thankthemaker/rESCue/docs/images/adafruit_products_Adafruit_ESP32_Huzzah_Breakout_Pinout.png

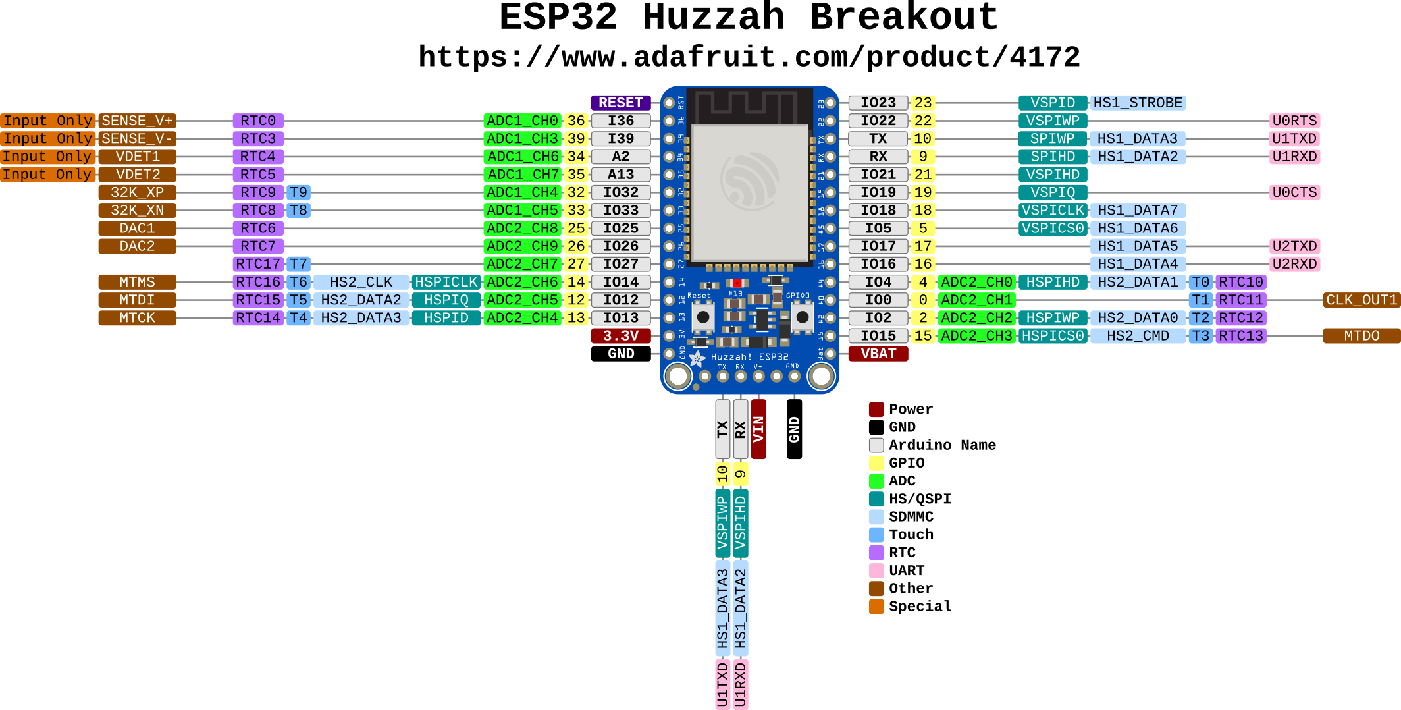
docs/images/adafruit_products_Adafruit_ESP32_Huzzah_Breakout_Pinout.png
