thankthemaker/rESCue/docs/images/rESCue-Blynk-QR.jpeg

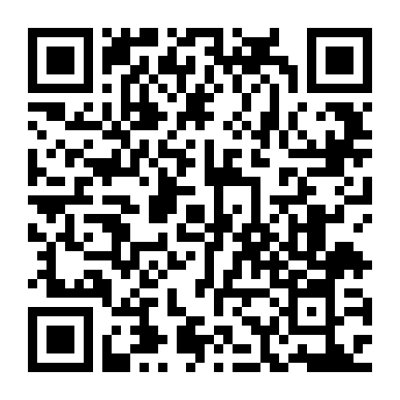
docs/images/rESCue-Blynk-QR.jpeg
