thankthemaker/rESCue/docs/images/rESCue-Blynk.png

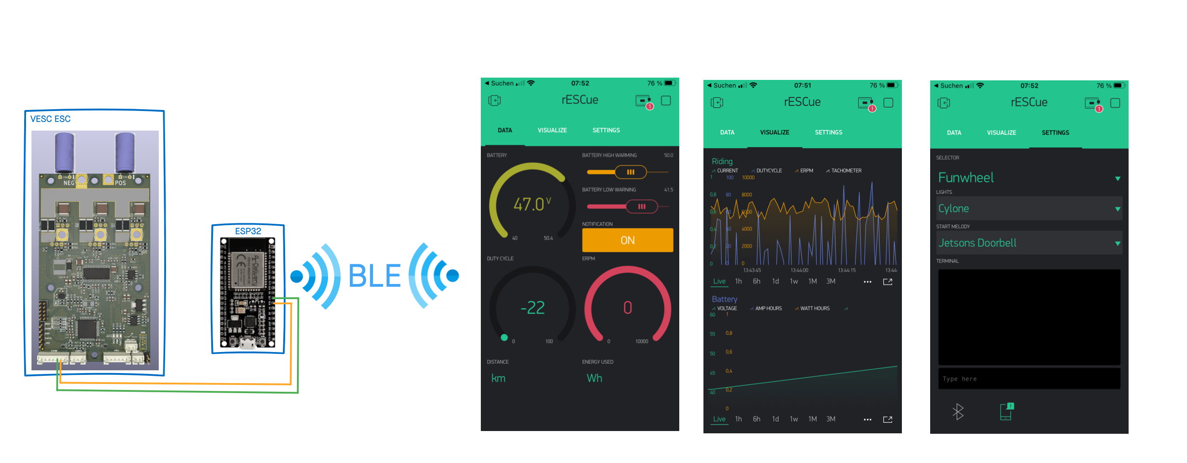
docs/images/rESCue-Blynk.png
