thankthemaker/rESCue/docs/images/wheelbarrow-rev3.png

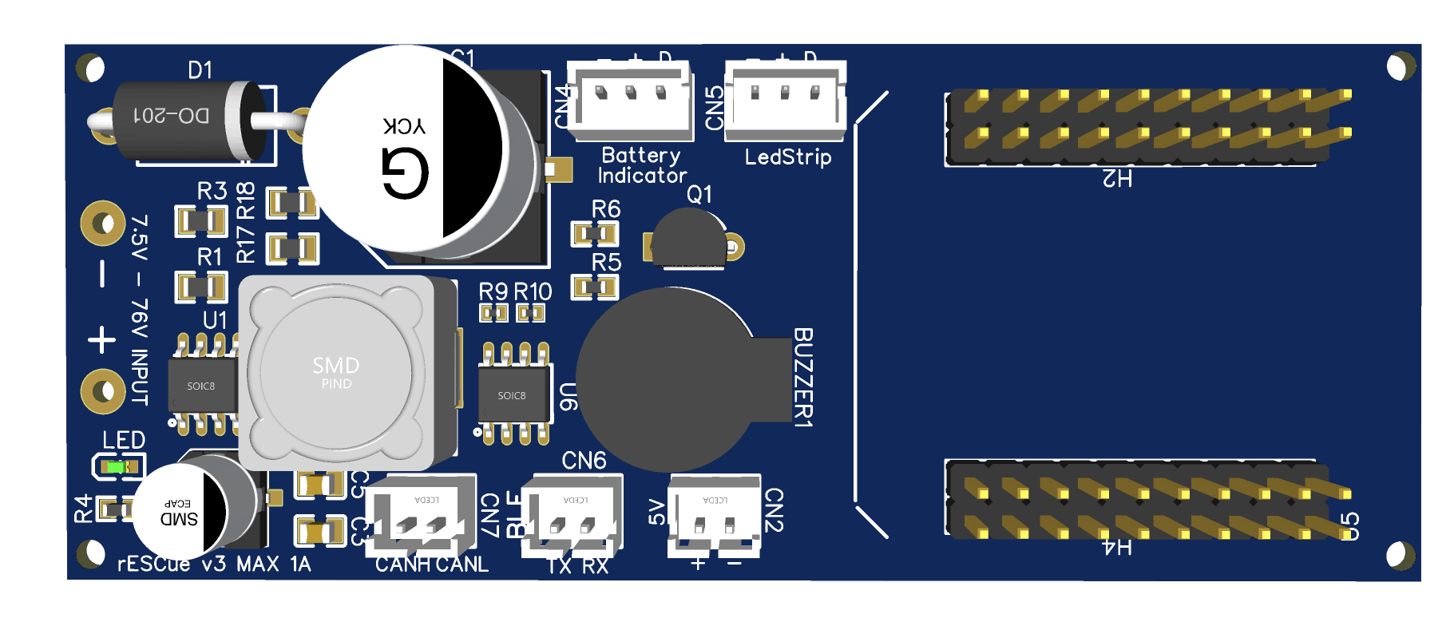
docs/images/wheelbarrow-rev3.png
