thankthemaker/rESCue/CHANGELOG.md

# Changelog for rESCue firmware
rESCue now uses Github releases, so you can see the changes in Github : https://github.com/thankthemaker/rESCue/releases

## Release 1.3.8 (not yet released)

## 12.09.2021

- switch to another CANBUS lib

## Release 1.3.7

## 12.09.2021

- Fixed some small issues in canbus
- switched back to stock version of the CANBUS lib  
- released v1.3.6

## Release 1.3.6

### 20.08.2021

- Fixed some issues when COB is used
- updated Readme, added MOSFET-Switch
- released v1.3.6

### 19.08.2021

- Fixed an issue in the CANBUS-lib. Sending messages without a working CANBUS makes ESP freeze

### 18.08.2021

- implemented changing LogLevel via Blynk-App

## Release 1.3.5

### 16.08.2021

- eliminated hard coded VESC-ID

## Release 1.3.4

### 16.08.2021

- fixed CAN-issue with VESC version 5.3
- prepared release 1.3.4

### 20.07.2021

- fixed WiFi OTA update by changing partition schema to default
- fixed "Guru Meditation Error: Core 1 panic'ed (Cache disabled but cached memory region accessed)" while OTA
- fixed app crash when App-Configuration is written and not dividable by 6 byte

## Release 1.3.3

### 19.07.2021

- improved CANBUS communication
- Fixed bug that CANBUS freezes when sending multiple frames at the same time

## Release 1.3.1

- bugfix lights, erpm was read wrong sometimes

## Release 1.3.0

### 27.06.2021

- prepared release 1.3.0

### 25.06.2021

- added Footpad sensor state to lightbar
- some small fixes

### 24.06.2021

- New light pattern pulse
- small bugfix, pattern change when start-sequence finished
- small bugfix, brightness ignored in start sequence

### 22.06.2021

- Updated Readme (CANBUS only)

## Release 1.2.0

### 15.06.2021

- implemented CANBUS-only read and write mode
- prepared release 1.2.0

### 08.06.2021

 - Working WiFI OTA

## Release 1.1.1

### 24.05.2021

- **Release 1.1.1**
- prepared release 1.1.1

### 24.05.2021

- prepared release 1.1.1
- improved OTA update, package resend and delay to give BLE stack time
- LightBar fixed
- bugfixing idle light

## Release 1.1.0

### 20.05.2021

- **Release 1.1.0**
- improved OTA and enrollment
- initial Lightbar
- startsound for OTA
- prepared release 1.1.0

### 15.05.2021

- updated README
- fixed wron macro definition

### 03.05.2021

- added OTA documentation

### 01.05.2021

- more configuration options

### 30.04.2021

- Updated Blynk App to v1.1
- Updated QR code

### 29.04.2021

- updated PIN configuration according to rev3 of the rESCue PCB
- updated documentation
- some more light magic

### 28.04.2021

- sound can be turned off
- added more sounds
- sound "preview" when selected
- Blynk app reads settings on connect
- fixed the fading bugs and made it smoother

### 27.04.2021

- fixed some bugs in fading lights
- smoother fading

### 20.04.2021

- updated doc, PCB image and sizing

## Release 1.0.0

### 19.04.2021

- **Release 1.0.0**
- added Over The Air (OTA) update
- changed partition layout (min-spiff)
- fixed blynk mapping

### 15.04.2021

- Fixed "braking lights"

### 14.04.2021

- updated outdated Adafruit Neopixel lib to 1.7.0

### 12.04.2021

- added syncPreferences to BleServer to sync saved preferences with Blynk onConnect
- added "brake light" detection when current <-4.0A (regen)
- read some more props from VESC ("totalCurrentIn" and "pidPosition")

- updated Blynk QR-Code
