thankthemaker/rESCue/(threads)

Thread 4 (2021-05-25):

piezo buzzer

Koxx3, 2021-05-25:
Hello,
very nice project !
I am curious about the piezo buzzer.
it works with an audible noise even in the enclosure with 3.3V ?
did you measure the current ? not drawing to much current from ESP pin ?
Regards,
F.

thankthemaker, 2021-05-25:
Hi,
to get a really loud sound, you'll need to add a simple transistor, e.g. a BC547.
If a buzzer does any harm to your ESP depends on the type. Piezo buzzer normally don't drain more than 20mA which is ok for the ESP32. Magnetic buzzer may drain much more and could damage the MCU.
Here is a good description:
https://diyi0t.com/active-passive-buzzer-arduino-esp8266-esp32/

I'd always recommend to use a transistor.

Koxx3, 2021-05-25:
thanks for the answer ;)
20 mA is already a lot for the ESP32 (12mA recommended if I have good memory)  ;)
I also think transistor is a good idea :D

thankthemaker, 2021-05-25:
According to the table on the page I posted, 12mA is for ESP8266.
The ESP32 can handle 20mA.
At least I never damaged an ESP32 by connecting a piezo buzzer.

Closed 2021-05-25.

Thread 5 (2021-05-25):

schematics for PCB

Koxx3, 2021-05-25:
hello,
could you publish the PCB schematics on the github ?
Regards,
F.

thankthemaker, 2021-05-25:
I'm not the creator of the PCB, so I can't publish the schematics.
Jonas is the guy who did a amazing job and he also told me he'll publish the complete project as open hardware once it is finished.

Koxx3, 2021-05-25:
awesome ;)
thanks for the feedback.
I am creating something a bit similar for escooters (with multiple controllers capability) ;)
https://github.com/Koxx3/SmartController_SmartDisplay_ESP32

If you have Telegram, we can talk (https://t.me/koxx3) 👍

thankthemaker, 2021-05-25:
Sounds great. Have to read it.

thankthemaker, 2021-06-05:
This repository contains only the firmware.
The hardware, once released as open hardware, will be placed in a new repository.

Closed 2021-06-05.

Thread 8 (2021-06-05):

Support for active piezo buzzer

thankthemaker, 2021-06-05:
The current firmware does only support passive piezo buzzer. Add support for active buzzers also.

Thread 15 (2021-09-07):

Feature request: turn off lights while charging

thankthemaker, 2021-09-07:
Floatwheel / Balance Pro turns on while charging, so it makes sense to turn off the lights when in idle state for longer than xx seconds.

thankthemaker, 2021-12-03:
Implemented an idle-light timeout. Its default value is 60 seconds but can be changed via app. When the timeout is reached while the wheel is still idle, the lights will completely turn off.

thankthemaker, 2021-12-03:
Available from version 2.0.0

Closed 2021-12-03.

Thread 16 (2021-11-12):

CAN bus / BLE gateway

Koxx3, 2021-11-12:
Hello,
do you think it would be possible to make a CAN <> BLE gateway ?

thankthemaker, 2021-11-13:
Hi, that's exactly what rESCue already does, at least if you're talking of the VESC protocol.
If you're talking about a generic solution, sure, this will also be possible but isn't part of rESCue already.

Could you please tell me a bit more, what exactly your intention is all about?

Koxx3, 2021-11-13:
I'd like to use it as a simple gateway for either BLE <> UART or BLE <> CAN.

BLE <> UART works fine. Now, I try the CAN version.

VESC configuration is in CAN_STATUS_1_2_3_4_5 enabled at 50Hz and 500KBps.
I currently have a single VESC (but I want it to work on dual CAN VESC).

I understood the proxyIn/proxyOut and got some results.
First, I had to reduce Logger traces. Verbose seems to give some issues (certainly slowing down the CAN frame processing).

But once connected in BLE, I can read real time datas, read MC/APP conf, but I can't write APP conf. Any idea why ? It's a long packet (but like MC conf), but I don't understand why this one is not working.

My test fork is here (I change the pinout for UART & CAN) :
https://github.com/Koxx3/rESCue

Koxx3, 2021-11-13:
I've just push the commit in the fork ;)

thankthemaker, 2021-11-13:
OK, so we're talking of the VESC protocol.
 I'll have to have a look at it. It might be a problem with the length of the config. Normally all data is passed to the CAN bus as is and vice versa, but due to different framing (package sizes) it has to be repacked. The VESC protocol distinguishes between different package sizes and I guess it could be a problem if e.g. the last CAN package isn't a complete package.

Koxx3, 2021-11-13:
even for MC conf writing, it doesn't work all the time

Koxx3, 2021-11-13:
working sequence :

`
FWC: [NOTICE] : BleServer BLE to VESC : len = 20
FWC: [NOTICE] : CanBus Proxy in  : STREAM => CAN, command 13, length 458, longPacket 1
FWC: [NOTICE] : BleServer BLE to VESC : len = 20
FWC: [NOTICE] : BleServer BLE to VESC : len = 20
FWC: [NOTICE] : BleServer BLE to VESC : len = 20
FWC: [NOTICE] : BleServer BLE to VESC : len = 20
FWC: [NOTICE] : BleServer BLE to VESC : len = 20
FWC: [NOTICE] : BleServer BLE to VESC : len = 20
FWC: [NOTICE] : BleServer BLE to VESC : len = 20
FWC: [NOTICE] : BleServer BLE to VESC : len = 20
FWC: [NOTICE] : BleServer BLE to VESC : len = 20
FWC: [NOTICE] : BleServer BLE to VESC : len = 20
FWC: [NOTICE] : BleServer BLE to VESC : len = 20
FWC: [NOTICE] : BleServer BLE to VESC : len = 20
FWC: [NOTICE] : BleServer BLE to VESC : len = 20
FWC: [NOTICE] : BleServer BLE to VESC : len = 20
FWC: [NOTICE] : BleServer BLE to VESC : len = 20
FWC: [NOTICE] : BleServer BLE to VESC : len = 20
FWC: [NOTICE] : BleServer BLE to VESC : len = 20
FWC: [NOTICE] : BleServer BLE to VESC : len = 20
FWC: [NOTICE] : BleServer BLE to VESC : len = 20
FWC: [NOTICE] : BleServer BLE to VESC : len = 20
FWC: [NOTICE] : BleServer BLE to VESC : len = 20
FWC: [NOTICE] : BleServer BLE to VESC : len = 20
FWC: [NOTICE] : BleServer BLE to VESC : len = 4
FWC: [NOTICE] : BleServer BLE to VESC : len = 6
FWC: [NOTICE] : CanBus Proxy in  : STREAM => CAN, command 14, length 1, longPacket 0
FWC: [NOTICE] : CanBus Proxy out : CAN => STREAM, sending 2 bytes
FWC: [NOTICE] : CanBus Proxy out : CAN => STREAM, sending 458 bytes
FWC: [NOTICE] : BleServer VESC to BLE : len = 471`

thankthemaker, 2021-11-13:
Are you using the VESC tool app for testing?

Koxx3, 2021-11-13:
yes, android vesctool with samsung Galaxy S10E.

Koxx3, 2021-11-13:
failing writing APP conf :

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

thankthemaker, 2021-11-13:
Ok, seems your fork is also behind the original master. Did you also try the latest master version from my original repository?
There were some changes, e.g. I separated the buffers to avoid influences of proxy / non proxy packages.

Koxx3, 2021-11-13:
oh ? I missed something then.
I think I've just checked out this one this morning.
Can you point me to the right link please ?

thankthemaker, 2021-11-13:
I'm referring to what the comparison of my and your master branches shows me:

https://github.com/thankthemaker/rESCue/compare/master...Koxx3:master

So, either you have to update your fork or check out the master of the original repo.

Koxx3, 2021-11-13:
ok, I'll restart from the start ;)
I'll keep you updated.
thanks

Koxx3, 2021-11-13:
updated !
and still the same issue.

Koxx3, 2021-11-13:
in fact, it's weird.
when I use the direct VESC BLE, I have the small green toast at the bottom confirming the write operation in Android vesctool.
when I use rescue, I don't have this toast, but datas seems to be taken into account by the VESC (may be partially ?)

Koxx3, 2021-11-13:
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

Koxx3, 2022-01-18:
I managed to get it working ;)

Closed 2022-01-18.

Thread 26 (2022-01-18):

CAN / BLE gateway with new officiel VESC 3.01 android app

Koxx3, 2022-01-18:
Hello,
it worked before, but now, it can't detect other VESC in CAN bus.
did you try the latest officiel android VESCTool release ?
Regards,
F.

Koxx3, 2022-01-18:
![Uploading Screenshot_20220118-212833.jpg…]()

Koxx3, 2022-01-18:
#
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

Koxx3, 2022-01-18:
First, it should show the second VESC
Second, tje timeout warning.

thankthemaker, 2022-01-20:
I haven't tried yet. Thanks for the hint, will have a look at it.

Koxx3, 2022-01-21:
```
// BLE<>UART sequence
10:29:38.325 > BluetoothHandler BLE => VESC : len = 006 / 02 01 3e d7 9d 03  // request CAN PING
10:29:40.903 > BluetoothHandler VESC => BLE : len = 006 / 02 02 3e c8 7e de
10:29:40.927 > BluetoothHandler VESC => BLE : len = 001 / 03
10:29:40.980 > BluetoothHandler BLE => VESC : len = 006 / 02 01 00 00 00 03
10:29:40.982 > BluetoothHandler VESC => BLE : len = 002 / 02 25
10:29:41.007 > BluetoothHandler VESC => BLE : len = 040 / 00 05 02 55 42 4f 58 5f 37 35 5f 33 30 30 5f 54 59 50 45 43
10:29:41.028 > BluetoothHandler VESC => BLE : len = 020 / 00 20 00 23 00 05 50 33 53 30 37 33 20 00 00 00 00 51 72 03
10:29:41.047 > BluetoothHandler BLE => VESC : len = 008 / 02 03 22 c8 00 77 5b 03
10:29:41.051 > BluetoothHandler VESC => BLE : len = 015 / 02 25 00 05 02 55 42 4f 58 5f 37 35 5f 33 30
10:29:41.075 > BluetoothHandler VESC => BLE : len = 027 / 30 5f 54 59 50 45 43 00 4e 00 37 00 0e 50 50 59 58 38 31 20
10:29:41.097 > BluetoothHandler VESC => BLE : len = 007 / 00 00 00 00 e8 9e 03

// BLE<>CAN sequence
10:33:45.187 > BluetoothHandler BLE => VESC : len = 006 / 02 01 3e d7 9d 03  // request CAN PING
10:33:47.766 > BluetoothHandler VESC => BLE : len = 008 / 02 03 01 3e c8 70 20 03
10:33:50.260 > BluetoothHandler BLE => VESC : len = 006 / 02 01 00 00 00 03
10:33:50.276 > BluetoothHandler VESC => BLE : len = 042 / 02 25 00 05 02 55 42 4f 58 5f 37 35 5f 33 30 30 5f 54 59 50
10:33:50.307 > BluetoothHandler VESC => BLE : len = 022 / 45 43 00 20 00 23 00 05 50 33 53 30 37 33 20 00 00 00 00 51
10:33:50.338 > BluetoothHandler VESC => BLE : len = 002 / 72 03
```

Koxx3, 2022-01-21:
in fact, even with older Vesctool, it didn't work.
Archive available here, tried 2.0.0 :
https://drive.google.com/drive/folders/1B7TBKsgpeKyqS-BKL1QFh0fiHb8Xv3XI

thankthemaker, 2022-01-21:
Please try the latest version 2.0.4
There was an issue of one of the older versions.

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

Koxx3, 2022-01-21:
i don't have the apk.
but not working with 3.0.1 anyway. so, not good since it's the only version
available on play store 😉
i found a bug in proxyin on short packet processing. i'll explain later.
wizzard can't work with this bug.

Le ven. 21 janv. 2022 à 19:50, ThankTheMaker ***@***.***> a
écrit :

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

thankthemaker, 2022-01-22:
I was talking about version 2.0.4 of rESCue, just to be precise. I‘ll do some tests with VESCtool later, but I know I tested the 2.0.4 of rESCue wit a 3.0.0 beta of VESCtool several times.

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

thankthemaker, 2022-04-16:
Should work starting with version 2.1.3

Koxx3, 2022-04-16:
thanks !
dit you test the can<>ble gw on fw 5.3 and 6.0 beta ?

thankthemaker, 2022-04-16:
I only tested it on 5.3.

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

Koxx3, 2022-04-18:
hello,
still having troubles
My test conditions :
- disable ledcontroller logs
- disabled CAN status 1/2/3/4/5 for less traces
- set verbose logs on rescue

BLE connects, but it fails try to get datas from CAN bus.

```
[E][Preferences.cpp:49] begin(): nvs_open failed: NOT_FOUND
[E][AppConfiguration.cpp:16] readPreferences(): no config file found
[E][AppConfiguration.cpp:23] readPreferences(): readPreferences:
FWC: [NOTICE] : BatteryMonitor initializing...
FWC: [NOTICE] : BleServer waiting a client connection to notify...
FWC: [NOTICE] : Ws28xxController initializing ...
FWC: [NOTICE] : Ws28xxController run startSequence
FWC: [NOTICE] : rESCue  sw-version 2.1.3 is happily running on hw-version 3.1
FWC: [NOTICE] : CanBus requestFirmwareVersion
FWC: [VERBOSE] : CanDevice Sending CAN frame 2147485721 DLC 3, [26, 0, 0, 0, 0, 0, 0, 0]
FWC: [VERBOSE] : CanBus name=, dutycycle=0.000000, erpm=0.000000, current=0.000000, ampHours=0.000000, ampHoursCharged=0.000000, wattHours=0.000000, wattHoursCharged=0.000000, mosfetTemp=0.000000, motorTemp=0.000000, inputVoltage=0.000000, tachometer=0.000000, pidOutput=0.000000, pitch=0.000000, roll=0.000000, loopTime=0, motorCurrent=0.000000, motorPosition=0.000000, balanceState=0, switchState=0, adc1=0.000000, adc2=0.000000, fault=0
FWC: [NOTICE] : CanBus requestFirmwareVersion
FWC: [VERBOSE] : CanDevice Sending CAN frame 2147485721 DLC 3, [26, 0, 0, 0, 0, 0, 0, 0]
FWC: [NOTICE] : CanBus requestFirmwareVersion
FWC: [VERBOSE] : CanDevice Sending CAN frame 2147485721 DLC 3, [26, 0, 0, 0, 0, 0, 0, 0]
FWC: [VERBOSE] : CanBus name=, dutycycle=0.000000, erpm=0.000000, current=0.000000, ampHours=0.000000, ampHoursCharged=0.000000, wattHours=0.000000, wattHoursCharged=0.000000, mosfetTemp=0.000000, motorTemp=0.000000, inputVoltage=0.000000, tachometer=0.000000, pidOutput=0.000000, pitch=0.000000, roll=0.000000, loopTime=0, motorCurrent=0.000000, motorPosition=0.000000, balanceState=0, switchState=0, adc1=0.000000, adc2=0.000000, fault=0
FWC: [NOTICE] : CanBus requestFirmwareVersion
FWC: [VERBOSE] : CanDevice Sending CAN frame 2147485721 DLC 3, [26, 0, 0, 0, 0, 0, 0, 0]
FWC: [NOTICE] : CanBus requestFirmwareVersion
FWC: [VERBOSE] : CanDevice Sending CAN frame 2147485721 DLC 3, [26, 0, 0, 0, 0, 0, 0, 0]
FWC: [ERROR] CANBUS initialization failed
FWC: [VERBOSE] : CanBus name=, dutycycle=0.000000, erpm=0.000000, current=0.000000, ampHours=0.000000, ampHoursCharged=0.000000, wattHours=0.000000, wattHoursCharged=0.000000, mosfetTemp=0.000000, motorTemp=0.000000, inputVoltage=0.000000, tachometer=0.000000, pidOutput=0.000000, pitch=0.000000, roll=0.000000, loopTime=0, motorCurrent=0.000000, motorPosition=0.000000, balanceState=0, switchState=0, adc1=0.000000, adc2=0.000000, fault=0
FWC: [VERBOSE] : CanBus name=, dutycycle=0.000000, erpm=0.000000, current=0.000000, ampHours=0.000000, ampHoursCharged=0.000000, wattHours=0.000000, wattHoursCharged=0.000000, mosfetTemp=0.000000, motorTemp=0.000000, inputVoltage=0.000000, tachometer=0.000000, pidOutput=0.000000, pitch=0.000000, roll=0.000000, loopTime=0, motorCurrent=0.000000, motorPosition=0.000000, balanceState=0, switchState=0, adc1=0.000000, adc2=0.000000, fault=0
FWC: [VERBOSE] : CanBus name=, dutycycle=0.000000, erpm=0.000000, current=0.000000, ampHours=0.000000, ampHoursCharged=0.000000, wattHours=0.000000, wattHoursCharged=0.000000, mosfetTemp=0.000000, motorTemp=0.000000, inputVoltage=0.000000, tachometer=0.000000, pidOutput=0.000000, pitch=0.000000, roll=0.000000, loopTime=0, motorCurrent=0.000000, motorPosition=0.000000, balanceState=0, switchState=0, adc1=0.000000, adc2=0.000000, fault=0
FWC: [VERBOSE] : CanBus name=, dutycycle=0.000000, erpm=0.000000, current=0.000000, ampHours=0.000000, ampHoursCharged=0.000000, wattHours=0.000000, wattHoursCharged=0.000000, mosfetTemp=0.000000, motorTemp=0.000000, inputVoltage=0.000000, tachometer=0.000000, pidOutput=0.000000, pitch=0.000000, roll=0.000000, loopTime=0, motorCurrent=0.000000, motorPosition=0.000000, balanceState=0, switchState=0, adc1=0.000000, adc2=0.000000, fault=0
FWC: [VERBOSE] : CanBus name=, dutycycle=0.000000, erpm=0.000000, current=0.000000, ampHours=0.000000, ampHoursCharged=0.000000, wattHours=0.000000, wattHoursCharged=0.000000, mosfetTemp=0.000000, motorTemp=0.000000, inputVoltage=0.000000, tachometer=0.000000, pidOutput=0.000000, pitch=0.000000, roll=0.000000, loopTime=0, motorCurrent=0.000000, motorPosition=0.000000, balanceState=0, switchState=0, adc1=0.000000, adc2=0.000000, fault=0
FWC: [NOTICE] : BleServer Client connected: 56:63:d9:0b:47:77
FWC: [NOTICE] : BleServer Multi-connect support: start advertising
FWC: [VERBOSE] : CanBus name=, dutycycle=0.000000, erpm=0.000000, current=0.000000, ampHours=0.000000, ampHoursCharged=0.000000, wattHours=0.000000, wattHoursCharged=0.000000, mosfetTemp=0.000000, motorTemp=0.000000, inputVoltage=0.000000, tachometer=0.000000, pidOutput=0.000000, pitch=0.000000, roll=0.000000, loopTime=0, motorCurrent=0.000000, motorPosition=0.000000, balanceState=0, switchState=0, adc1=0.000000, adc2=0.000000, fault=0
FWC: [NOTICE] : BleServer Client ID: 0, Address: 56:63:d9:0b:47:77, Subvalue 1, Characteristics 6e400003-b5a3-f393-e0a9-e50e24dcca9e
FWC: [NOTICE] : BleServer onWrite to characteristics: 6e400002-b5a3-f393-e0a9-e50e24dcca9e
FWC: [NOTICE] : BleServer onWrite - value: ␂␁

FWC: [VERBOSE] : BleCanProxy Proxy in, command 0, length 1

FWC: [VERBOSE] : CanDevice Sending CAN frame 2147485721 DLC 3, [27, 0, 0, 0, 0, 0, 0, 0]
FWC: [VERBOSE] : CanBus name=, dutycycle=0.000000, erpm=0.000000, current=0.000000, ampHours=0.000000, ampHoursCharged=0.000000, wattHours=0.000000, wattHoursCharged=0.000000, mosfetTemp=0.000000, motorTemp=0.000000, inputVoltage=0.000000, tachometer=0.000000, pidOutput=0.000000, pitch=0.000000, roll=0.000000, loopTime=0, motorCurrent=0.000000, motorPosition=0.000000, balanceState=0, switchState=0, adc1=0.000000, adc2=0.000000, fault=0
FWC: [NOTICE] : BleServer onWrite to characteristics: 6e400002-b5a3-f393-e0a9-e50e24dcca9e
FWC: [NOTICE] : BleServer onWrite - value: ␂␁␎��␃

FWC: [VERBOSE] : BleCanProxy Proxy in, command 14, length 1

FWC: [VERBOSE] : CanDevice Sending CAN frame 2147485721 DLC 3, [27, 0, 14, 0, 0, 0, 0, 0]
FWC: [NOTICE] : BleServer onWrite to characteristics: 6e400002-b5a3-f393-e0a9-e50e24dcca9e
FWC: [NOTICE] : BleServer onWrite - value: ␂␁␑␂␐␃

FWC: [VERBOSE] : BleCanProxy Proxy in, command 17, length 1

FWC: [VERBOSE] : CanDevice Sending CAN frame 2147485721 DLC 3, [27, 0, 17, 0, 0, 0, 0, 0]
FWC: [VERBOSE] : CanBus name=, dutycycle=0.000000, erpm=0.000000, current=0.000000, ampHours=0.000000, ampHoursCharged=0.000000, wattHours=0.000000, wattHoursCharged=0.000000, mosfetTemp=0.000000, motorTemp=0.000000, inputVoltage=0.000000, tachometer=0.000000, pidOutput=0.000000, pitch=0.000000, roll=0.000000, loopTime=0, motorCurrent=0.000000, motorPosition=0.000000, balanceState=0, switchState=0, adc1=0.000000, adc2=0.000000, fault=0
FWC: [NOTICE] : BleServer onWrite to characteristics: 6e400002-b5a3-f393-e0a9-e50e24dcca9e
FWC: [NOTICE] : BleServer onWrite - value: ␂␁

FWC: [VERBOSE] : BleCanProxy Proxy in, command 0, length 1

FWC: [VERBOSE] : CanDevice Sending CAN frame 2147485721 DLC 3, [27, 0, 0, 0, 0, 0, 0, 0]
FWC: [NOTICE] : BleServer onWrite to characteristics: 6e400002-b5a3-f393-e0a9-e50e24dcca9e
FWC: [NOTICE] : BleServer onWrite - value: ␂␁␎��␃

FWC: [VERBOSE] : BleCanProxy Proxy in, command 14, length 1

FWC: [VERBOSE] : CanDevice Sending CAN frame 2147485721 DLC 3, [27, 0, 14, 0, 0, 0, 0, 0]
FWC: [NOTICE] : BleServer onWrite to characteristics: 6e400002-b5a3-f393-e0a9-e50e24dcca9e
FWC: [NOTICE] : BleServer onWrite - value: ␂␁␑␂␐␃

FWC: [VERBOSE] : BleCanProxy Proxy in, command 17, length 1

FWC: [VERBOSE] : CanDevice Sending CAN frame 2147485721 DLC 3, [27, 0, 17, 0, 0, 0, 0, 0]
FWC: [VERBOSE] : CanBus name=, dutycycle=0.000000, erpm=0.000000, current=0.000000, ampHours=0.000000, ampHoursCharged=0.000000, wattHours=0.000000, wattHoursCharged=0.000000, mosfetTemp=0.000000, motorTemp=0.000000, inputVoltage=0.000000, tachometer=0.000000, pidOutput=0.000000, pitch=0.000000, roll=0.000000, loopTime=0, motorCurrent=0.000000, motorPosition=0.000000, balanceState=0, switchState=0, adc1=0.000000, adc2=0.000000, fault=0
FWC: [NOTICE] : BleServer Client ID: 0, Address: 56:63:d9:0b:47:77, Subvalue 0, Characteristics 6e400003-b5a3-f393-e0a9-e50e24dcca9e
FWC: [NOTICE] : BleServer Client disconnected - start advertising
FWC: [NOTICE] : BleServer start advertising
FWC: [VERBOSE] : CanBus name=, dutycycle=0.000000, erpm=0.000000, current=0.000000, ampHours=0.000000, ampHoursCharged=0.000000, wattHours=0.000000, wattHoursCharged=0.000000, mosfetTemp=0.000000, motorTemp=0.000000, inputVoltage=0.000000, tachometer=0.000000, pidOutput=0.000000, pitch=0.000000, roll=0.000000, loopTime=0, motorCurrent=0.000000, motorPosition=0.000000, balanceState=0, switchState=0, adc1=0.000000, adc2=0.000000, fault=0
FWC: [VERBOSE] : CanBus name=, dutycycle=0.000000, erpm=0.000000, current=0.000000, ampHours=0.000000, ampHoursCharged=0.000000, wattHours=0.000000, wattHoursCharged=0.000000, mosfetTemp=0.000000, motorTemp=0.000000, inputVoltage=0.000000, tachometer=0.000000, pidOutput=0.000000, pitch=0.000000, roll=0.000000, loopTime=0, motorCurrent=0.000000, motorPosition=0.000000, balanceState=0, switchState=0, adc1=0.000000, adc2=0.000000, fault=0

```

Koxx3, 2022-04-18:
traces with only CAN STATUS 1 enabled :

```
FWC: [NOTICE] : CanBus requestRealtimeData
FWC: [VERBOSE] : CanDevice Sending CAN frame 2147485721 DLC 7, [26, 0, 50, 0, 0, 135, 195, 0]
FWC: [NOTICE] : CanBus requestBalanceData
FWC: [VERBOSE] : CanDevice Sending CAN frame 2147485721 DLC 3, [26, 0, 79, 0, 0, 0, 0, 0]
#1 from 0x00000902, DLC 8, data [0      0       0       0       0       0       0       0]
FWC: [VERBOSE] : CanBus processed frame #1, type
#2 from 0x00000902, DLC 8, data [0      0       0       0       0       0       0       0]
FWC: [VERBOSE] : CanBus processed frame #2, type
FWC: [NOTICE] : CanBus requestRealtimeData
FWC: [VERBOSE] : CanDevice Sending CAN frame 2147485721 DLC 7, [26, 0, 50, 0, 0, 135, 195, 0]
FWC: [NOTICE] : CanBus requestBalanceData
FWC: [VERBOSE] : CanDevice Sending CAN frame 2147485721 DLC 3, [26, 0, 79, 0, 0, 0, 0, 0]
#1 from 0x00000902, DLC 8, data [0      0       0       0       0       0       0       0]
FWC: [VERBOSE] : CanBus processed frame #1, type
#2 from 0x00000902, DLC 8, data [0      0       0       0       0       0       0       0]
FWC: [VERBOSE] : CanBus processed frame #2, type
FWC: [NOTICE] : CanBus requestRealtimeData
FWC: [VERBOSE] : CanDevice Sending CAN frame 2147485721 DLC 7, [26, 0, 50, 0, 0, 135, 195, 0]
FWC: [NOTICE] : CanBus requestBalanceData
FWC: [VERBOSE] : CanDevice Sending CAN frame 2147485721 DLC 3, [26, 0, 79, 0, 0, 0, 0, 0]
#1 from 0x00000902, DLC 8, data [0      0       0       0       0       0       0       0]
FWC: [VERBOSE] : CanBus processed frame #1, type
#2 from 0x00000902, DLC 8, data [0      0       0       0       0       0       0       0]
FWC: [VERBOSE] : CanBus processed frame #2, type
FWC: [NOTICE] : CanBus requestRealtimeData
FWC: [VERBOSE] : CanDevice Sending CAN frame 2147485721 DLC 7, [26, 0, 50, 0, 0, 135, 195, 0]
FWC: [NOTICE] : CanBus requestBalanceData
FWC: [VERBOSE] : CanDevice Sending CAN frame 2147485721 DLC 3, [26, 0, 79, 0, 0, 0, 0, 0]
#1 from 0x00000902, DLC 8, data [0      0       0       0       0       0       0       0]
FWC: [VERBOSE] : CanBus processed frame #1, type
#2 from 0x00000902, DLC 8, data [0      0       0       0       0       0       0       0]
FWC: [VERBOSE] : CanBus processed frame #2, type
FWC: [NOTICE] : CanBus requestRealtimeData
FWC: [VERBOSE] : CanDevice Sending CAN frame 2147485721 DLC 7, [26, 0, 50, 0, 0, 135, 195, 0]
FWC: [NOTICE] : CanBus requestBalanceData
FWC: [VERBOSE] : CanDevice Sending CAN frame 2147485721 DLC 3, [26, 0, 79, 0, 0, 0, 0, 0]
#1 from 0x00000902, DLC 8, data [0      0       0       0       0       0       0       0]
FWC: [VERBOSE] : CanBus processed frame #1, type
#2 from 0x00000902, DLC 8, data [0      0       0       0       0       0       0       0]
FWC: [VERBOSE] : CanBus processed frame #2, type
FWC: [NOTICE] : CanBus requestRealtimeData
FWC: [VERBOSE] : CanDevice Sending CAN frame 2147485721 DLC 7, [26, 0, 50, 0, 0, 135, 195, 0]
FWC: [NOTICE] : CanBus requestBalanceData
FWC: [VERBOSE] : CanDevice Sending CAN frame 2147485721 DLC 3, [26, 0, 79, 0, 0, 0, 0, 0]
#1 from 0x00000902, DLC 8, data [0      0       0       0       0       0       0       0]
FWC: [VERBOSE] : CanBus processed frame #1, type
#2 from 0x00000902, DLC 8, data [0      0       0       0       0       0       0       0]
FWC: [VERBOSE] : CanBus processed frame #2, type
FWC: [NOTICE] : CanBus requestRealtimeData
FWC: [VERBOSE] : CanDevice Sending CAN frame 2147485721 DLC 7, [26, 0, 50, 0, 0, 135, 195, 0]
FWC: [NOTICE] : CanBus requestBalanceData
FWC: [VERBOSE] : CanDevice Sending CAN frame 2147485721 DLC 3, [26, 0, 79, 0, 0, 0, 0, 0]
#1 from 0x00000902, DLC 8, data [0      0       0       0       0       0       0       0]
FWC: [VERBOSE] : CanBus processed frame #1, type
#2 from 0x00000902, DLC 8, data [0      0       0       0       0       0       0       0]
FWC: [VERBOSE] : CanBus processed frame #2, type
#3 from 0x00000902, DLC 8, data [0      0       0       0       0       0       0       0]
FWC: [VERBOSE] : CanBus processed frame #3, type
FWC: [NOTICE] : CanBus requestRealtimeData
FWC: [VERBOSE] : CanDevice Sending CAN frame 2147485721 DLC 7, [26, 0, 50, 0, 0, 135, 195, 0]
FWC: [NOTICE] : CanBus requestBalanceData
FWC: [VERBOSE] : CanDevice Sending CAN frame 2147485721 DLC 3, [26, 0, 79, 0, 0, 0, 0, 0]
#1 from 0x00000902, DLC 8, data [0      0       0       0       0       0       0       0]
FWC: [VERBOSE] : CanBus processed frame #1, type
#2 from 0x00000902, DLC 8, data [0      0       0       0       0       0       0       0]
FWC: [VERBOSE] : CanBus processed frame #2, type
FWC: [NOTICE] : CanBus requestRealtimeData
FWC: [VERBOSE] : CanDevice Sending CAN frame 2147485721 DLC 7, [26, 0, 50, 0, 0, 135, 195, 0]
FWC: [NOTICE] : CanBus requestBalanceData
FWC: [VERBOSE] : CanDevice Sending CAN frame 2147485721 DLC 3, [26, 0, 79, 0, 0, 0, 0, 0]
```

thankthemaker, 2022-04-18:
`FWC: [ERROR] CANBUS initialization failed
`
Did you check the VESC-ID in VESC-Tool matches the one configured in rESCue? rESCue assumes ID 25 for VESC by default and uses 26 (rESCue itself) and 27 (BLE-proxy) for. To be precise, it uses VESC-ID+1 and VESC-ID+2 for its own IDs.

From the Log I'd say, the initialization failed because the IDs didn't match.

Koxx3, 2022-04-18:
it was my first mistake. I've just changed it to "1" (my first VESC core ID is 1 and the second is 2).
I am now trying without traces (I noticed it can have an impact)

Koxx3, 2022-04-18:
reading MC config : working
reading APP config : working
writing MC config : NOT working
writing APP config : NOT working

Koxx3, 2022-04-18:
> `FWC: [ERROR] CANBUS initialization failed ` Did you check the VESC-ID in VESC-Tool matches the one configured in rESCue? rESCue assumes ID 25 for VESC by default and uses 26 (rESCue itself) and 27 (BLE-proxy) for. To be precise, it uses VESC-ID+1 and VESC-ID+2 for its own IDs.
>
> From the Log I'd say, the initialization failed because the IDs didn't match.

you mean I can't use it with 2 VESCs ? or I need to set only the higher ID (2 in my case), so it will use 3&4 ? it will still manage to access 1 ?

thankthemaker, 2022-04-18:
rESCue doesn't support multiple VESC at the moment. I haven't dealt with multiple VESCs so I don't have any experience.

Koxx3, 2022-04-18:
> rESCue doesn't support multiple VESC at the moment. I haven't dealt with multiple VESCs so I don't have any experience.

ahhhhhh ! ok ! it eaplains some things then ;)
I'll cut CAN between both ESC cores to test with a single ESC.

Koxx3, 2022-04-18:
same issue while trying to write MC configuration with single VESC (VESC CAN ID = 1 / config.h = 1) :

```
#4 from 0x00000502, DLC 8, data [21     0       0       0       0       0       0       0]
FWC: [VERBOSE] : CanBus processed frame #4, type fill rx buffer
#5 from 0x00000502, DLC 8, data [28     0       0       0       0       0       0       0]
FWC: [VERBOSE] : CanBus processed frame #5, type fill rx buffer
#6 from 0x00000502, DLC 7, data [35     0       0       0       0       0       0       0]
FWC: [VERBOSE] : CanBus processed frame #6, type fill rx buffer
#7 from 0x00000702, DLC 6, data [1      1       0       41      112     202     0       0]
FWC: [VERBOSE] : CanBus processed frame #7, type process rx buffer for COMM_GET_DECODED_BALANCE
FWC: [NOTICE] : CanBus requestRealtimeData
FWC: [VERBOSE] : CanDevice Sending CAN frame 2147485697 DLC 7, [2, 0, 50, 0, 0, 135, 195, 0]
#1 from 0x00000502, DLC 8, data [0      50      0       0       135     195     1       64]
FWC: [VERBOSE] : CanBus processed frame #1, type fill rx buffer
#2 from 0x00000502, DLC 8, data [7      252     25      0       0       0       0       0]
FWC: [VERBOSE] : CanBus processed frame #2, type fill rx buffer
#3 from 0x00000502, DLC 8, data [14     0       2       33      0       0       0       0]
FWC: [VERBOSE] : CanBus processed frame #3, type fill rx buffer
#4 from 0x00000502, DLC 6, data [21     0       0       0       0       0       0       0]
FWC: [VERBOSE] : CanBus processed frame #4, type fill rx buffer
#5 from 0x00000702, DLC 6, data [1      1       0       26      54      145     0       0]
FWC: [VERBOSE] : CanBus processed frame #5, type process rx buffer for COMM_GET_VALUES_SELECTIVE
FWC: [NOTICE] : CanBus requestBalanceData
FWC: [VERBOSE] : CanDevice Sending CAN frame 2147485697 DLC 3, [2, 0, 79, 0, 0, 0, 0, 0]
#1 from 0x00000502, DLC 8, data [0      79      0       0       0       0       0       0]
FWC: [VERBOSE] : CanBus processed frame #1, type fill rx buffer
#2 from 0x00000502, DLC 8, data [7      0       0       0       0       0       0       0]
FWC: [VERBOSE] : CanBus processed frame #2, type fill rx buffer
#3 from 0x00000502, DLC 8, data [14     0       0       0       0       0       0       0]
FWC: [VERBOSE] : CanBus processed frame #3, type fill rx buffer
#4 from 0x00000502, DLC 8, data [21     0       0       0       0       0       0       0]
FWC: [VERBOSE] : CanBus processed frame #4, type fill rx buffer
#5 from 0x00000502, DLC 8, data [28     0       0       0       0       0       0       0]
FWC: [VERBOSE] : CanBus processed frame #5, type fill rx buffer
#6 from 0x00000502, DLC 7, data [35     0       0       0       0       0       0       0]
FWC: [VERBOSE] : CanBus processed frame #6, type fill rx buffer
#7 from 0x00000702, DLC 6, data [1      1       0       41      112     202     0       0]
FWC: [VERBOSE] : CanBus processed frame #7, type process rx buffer for COMM_GET_DECODED_BALANCE
FWC: [VERBOSE] : CanBus name=UBOX_V2_75_3, dutycycle=0.000000, erpm=0.000000, current=0.000000, ampHours=0.000000, ampHoursCharged=0.000000, wattHours=0.000000, wattHoursCharged=0.000000, mosfetTemp=32.000000, motorTemp=-99.900000, inputVoltage=54.500000, tachometer=0.000000, pidOutput=0.000000, pitch=0.000000, roll=0.000000, loopTime=0, motorCurrent=0.000000, motorPosition=0.000000, balanceState=0, switchState=0, adc1=0.000000, adc2=0.000000, fault=0
FWC: [NOTICE] : CanBus requestRealtimeData
FWC: [VERBOSE] : CanDevice Sending CAN frame 2147485697 DLC 7, [2, 0, 50, 0, 0, 135, 195, 0]
#1 from 0x00000502, DLC 8, data [0      50      0       0       135     195     1       64]
FWC: [VERBOSE] : CanBus processed frame #1, type fill rx buffer
#2 from 0x00000502, DLC 8, data [7      252     24      0       1       0       0       0]
FWC: [VERBOSE] : CanBus processed frame #2, type fill rx buffer
#3 from 0x00000502, DLC 8, data [14     0       2       33      0       0       0       0]
FWC: [VERBOSE] : CanBus processed frame #3, type fill rx buffer
#4 from 0x00000502, DLC 6, data [21     0       0       0       0       0       0       0]
FWC: [VERBOSE] : CanBus processed frame #4, type fill rx buffer
#5 from 0x00000702, DLC 6, data [1      1       0       26      110     132     0       0]
FWC: [VERBOSE] : CanBus processed frame #5, type process rx buffer for COMM_GET_VALUES_SELECTIVE
FWC: [NOTICE] : CanBus requestBalanceData
FWC: [VERBOSE] : CanDevice Sending CAN frame 2147485697 DLC 3, [2, 0, 79, 0, 0, 0, 0, 0]
#1 from 0x00000502, DLC 8, data [0      79      0       0       0       0       0       0]
FWC: [VERBOSE] : CanBus processed frame #1, type fill rx buffer
#2 from 0x00000502, DLC 8, data [7      0       0       0       0       0       0       0]
FWC: [VERBOSE] : CanBus processed frame #2, type fill rx buffer
#3 from 0x00000502, DLC 8, data [14     0       0       0       0       0       0       0]
FWC: [VERBOSE] : CanBus processed frame #3, type fill rx buffer
#4 from 0x00000502, DLC 8, data [21     0       0       0       0       0       0       0]
FWC: [VERBOSE] : CanBus processed frame #4, type fill rx buffer
#5 from 0x00000502, DLC 8, data [28     0       0       0       0       0       0       0]
FWC: [VERBOSE] : CanBus processed frame #5, type fill rx buffer
#6 from 0x00000502, DLC 7, data [35     0       0       0       0       0       0       0]
FWC: [VERBOSE] : CanBus processed frame #6, type fill rx buffer
#7 from 0x00000702, DLC 6, data [1      1       0       41      112     202     0       0]
FWC: [VERBOSE] : CanBus processed frame #7, type process rx buffer for COMM_GET_DECODED_BALANCE
FWC: [NOTICE] : CanBus requestRealtimeData
FWC: [VERBOSE] : CanDevice Sending CAN frame 2147485697 DLC 7, [2, 0, 50, 0, 0, 135, 195, 0]
#1 from 0x00000502, DLC 8, data [0      50      0       0       135     195     1       64]
FWC: [VERBOSE] : CanBus processed frame #1, type fill rx buffer
#2 from 0x00000502, DLC 8, data [7      252     25      0       0       0       0       0]
FWC: [VERBOSE] : CanBus processed frame #2, type fill rx buffer
#3 from 0x00000502, DLC 8, data [14     0       2       33      0       0       0       0]
FWC: [VERBOSE] : CanBus processed frame #3, type fill rx buffer
#4 from 0x00000502, DLC 6, data [21     0       0       0       0       0       0       0]
FWC: [VERBOSE] : CanBus processed frame #4, type fill rx buffer
#5 from 0x00000702, DLC 6, data [1      1       0       26      54      145     0       0]
FWC: [VERBOSE] : CanBus processed frame #5, type process rx buffer for COMM_GET_VALUES_SELECTIVE
FWC: [VERBOSE] : CanBus name=UBOX_V2_75_3, dutycycle=0.000000, erpm=0.000000, current=0.000000, ampHours=0.000000, ampHoursCharged=0.000000, wattHours=0.000000, wattHoursCharged=0.000000, mosfetTemp=32.000000, motorTemp=-99.900000, inputVoltage=54.500000, tachometer=0.000000, pidOutput=0.000000, pitch=0.000000, roll=0.000000, loopTime=0, motorCurrent=0.000000, motorPosition=0.000000, balanceState=0, switchState=0, adc1=0.000000, adc2=0.000000, fault=0
FWC: [NOTICE] : CanBus requestBalanceData
FWC: [VERBOSE] : CanDevice Sending CAN frame 2147485697 DLC 3, [2, 0, 79, 0, 0, 0, 0, 0]
#1 from 0x00000502, DLC 8, data [0      79      0       0       0       0       0       0]
FWC: [VERBOSE] : CanBus processed frame #1, type fill rx buffer
#2 from 0x00000502, DLC 8, data [7      0       0       0       0       0       0       0]
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

Thread 27 (2022-02-04):

SwitchState being printed out as BalanceState

skelstar, 2022-02-04:
I'm wondering if this was right:
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

thankthemaker, 2022-02-07:
Thanks for the hint. Of Course this is wrong. I'll fix it.

Closed 2022-04-16.

Thread 35 (2022-04-29):

Bug? after idle time, no front and back litgh restart.

MadeInFondDuGarage, 2022-04-29:
when i use it, i wait some long time, (discus with my frien).
front and back ligth go off (idle time).
i put my foot on, and nothing change, the back and front alway off, and the litghbar dont go to blue. the board steel ok i can ride.

i need a restart (switch off /on) to recover the litgh.

thankthemaker, 2022-05-11:
Could you please tell me which firmware version you're on?
Does this happen every time your rESCue enters idle mode or only sometimes? I wasn't able to reproduce so far.

MadeInFondDuGarage, 2022-05-14:
hello i make more test, with my son to see the ligth.
after this, i can t  reproduce it.
what i see.
i turn on the board, i have the start light, and the idle. if i put the max time after the time light go off, if i put zero light alway on.
i go ride, the front and back litgh are ok.
i stop , the light directly go off (no idle light)
i restart the ride, the ligth go on but not imediatly, i need to go a little to active them.

thankthemaker, 2022-10-09:
Ok, today I tried to reproduce with version 2.2.1 but I had no luck.
Could you please tell me which version your on and maybe try with 2.2.1 again, if you're running another version.
Could you please also check if "verbose" logging is enabled in rESCue app and what "Can status rate" and "Can status message mode" you've set in VESC tool.

I guess it's a combination of MCU overload due to verbose logging enabled and a high  "status rate". You could try with
only 5Hz and CAN_STATUS_1 and Loglevel "notice" in rESCue App.

If the issue still occurs, please reopen the issue

Closed 2022-10-09.

Thread 40 (2022-06-20):

Feature: Battery Capacity in Settings maxes out at 4000mAh

ty8447, 2022-06-20:
I am currently using 16 Molicel P42A cells in my onewheel build (4200mAh per cell) and in the app, the max capacity slider is 4000mAh. Would it be possible to make the max of the slider be 5000mAh instead of 4000mAh?

Closed 2022-07-17.

Thread 41 (2022-06-20):

Bug: In Device Settings, the currently selected settings are not read when trying to change that setting.

ty8447, 2022-06-20:
Specifically when trying to edit the battery configuration in the device settings, the option get reset every time the menu is opened instead of recalling the current settings. This becomes annoying quickly when you want to change only a single setting and upon saving, notice that the other options in the menu have been set back to default.

Closed 2022-07-17.

Thread 42 (2022-07-29):

Bug: Battery Indicator Footpad Indication not adjusting

ty8447, 2022-07-29:
When half of the footpad is stepped on, the amount of LEDs that turn on to show what footpad is pressed does not adjust depending on the size of the strip used. When an even number of LEDs is specified it should divide the strip in half and use that, and when an odd number of LEDs is specified it should subtract 1, divide the number of LEDs in half and then use that amount.

What would make a lot of sense would be to add an option in the settings menu on the app to customize how many LEDs are used for that detection and the padding in the middle of the two halves.

thankthemaker, 2022-10-09:
Thank's for your feedback. The number of pixels is already adjustable in the wizard and also in the rESCue-App settings, it is still called "Battery Monitor -> Number of pixel". I'll change this with the next update to somethong more meaningful.

But you're still right regarding the odd/even problem.  I'll fix it in the next firmware update

thankthemaker, 2022-10-09:
Fixed in 2.2.2

Closed 2022-10-09.

Thread 44 (2022-10-09):

Idle light flickering

thankthemaker, 2022-10-09:
Some users reported flickering idle light. This happens when the light pattern is repeated, e.g. rainbow light.
The root cause is the resetting of all pixels, which was introduced with the battery indicator idle light pattern in 2.2.1.

Thread 57 (2022-12-11):

Can not get BLE-Uart bridge to work

aka13-404, 2022-12-11:
Great coneption! Sadly, seemingly my incompetence  does not permit me to get the BLE bridge working.
I flash the esp successfully, I am connected to the uart on the VESC (I had an nrf working properly there), I am soldered to GPIO 16 &17, I have APP set to UARD on my single ubox. I can successfully connect to the flashed ESP, but get "make sure port belongs to vesc".
What could I be doing wrong? I have just to be sure swapped the tx-rx cables a couple of times to no success.
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

thankthemaker, 2022-12-11:
How did you build the rEScue firmware? It's preconfigured to use CANBUS, to switch to UART you have to build it with CANBUS-only disabled in config.h

Also make sure to connect the ESP and the VESC to the same GND, UART needs a common GND.

aka13-404, 2022-12-11:
I have to admit, this is the very first time I build anything for embed myself.
I never bothered to check any configs, since the readme did not mention them.

What would I configure, if the only thing I need is the uart-ble bridge?

aka13-404, 2022-12-11:
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
Well, this has worked perfectly. I connect and read VESC as expected.
I tried to comment out all the LED stuff (for now it is unlikely, that I will run LEDs), but it errored out. Guess, there is no "no led mode" :D
Thank you again, you saved my evening.

thankthemaker, 2022-12-11:
Sorry, I mismatched CANBUS_Enabled and CANBUS_only.
Why did you need to comment out LED stuff?

aka13-404, 2022-12-11:
Well, as mentioned, right now and for the foreseeable future I only care about the ble-uart bridge. All else looks pretty sweet, but right now I don't use it, so I thought that perhaps it's modular and I should disable it for now.

svenkvade, 2023-02-06:
If I were to only use this as a replacement for the bluetooth modules as a BLE-UART bridge, would this run on an ESP8266 as well? Or better to just get a 32 regardless? Thanks

topoll113, 2023-02-07:
@thankthemaker same as author Im not able to make UART work with VESC tool . I out commented " #define CANBUS ENABLED " in config.h and also changed " default_envs = wemos_d1_mini32 " to " default_envs = nodemcu-32s " in platformio.ini in order to match my board. rESCue app reading VESC values . I hooked ESP32 with VESC 75100. I tried 6.0, 5.02 and 5.01 firmware but no luck with any of them... Any idea ?

thankthemaker, 2023-02-08:
> @thankthemaker same as author Im not able to make UART work with VESC tool . I out commented " #define CANBUS ENABLED " in config.h and also changed " default_envs = wemos_d1_mini32 " to " default_envs = nodemcu-32s " in platformio.ini in order to match my board. rESCue app reading VESC values . I hooked ESP32 with VESC 75100. I tried 6.0, 5.02 and 5.01 firmware but no luck with any of them... Any idea ? Edit: rESCue not working with VESC Tool 6.0 but It does with 3.01. Any chance that this could be fixed ?

It should work, have yuo checked the PINs? The ESP32 has 3 UART ports, which one did you use?
It's also important to use a common GND for ESP32 and VESC.

topoll113, 2023-02-08:
> > @thankthemaker same as author Im not able to make UART work with VESC tool . I out commented " #define CANBUS ENABLED " in config.h and also changed " default_envs = wemos_d1_mini32 " to " default_envs = nodemcu-32s " in platformio.ini in order to match my board. rESCue app reading VESC values . I hooked ESP32 with VESC 75100. I tried 6.0, 5.02 and 5.01 firmware but no luck with any of them... Any idea ? Edit: rESCue not working with VESC Tool 6.0 but It does with 3.01. Any chance that this could be fixed ?
>
> It should work, have yuo checked the PINs? The ESP32 has 3 UART ports, which one did you use? It's also important to use a common GND for ESP32 and VESC.

Wiring is okay. I connected UART to pin 16 & 17. I’m getting reading in rESCue app and I’m able to connect with VESC Tool ver. 3.01. When I’m trying connect with VESC Tool ver. 6 I’m getting message: “ Could not read firmware version. Make sure that selected port really belongs to VESC”.

Closed 2022-12-11.

Thread 61 (2023-07-11):

Connecting a ESP32 devkit v1 to Flipsky fsesc75100

LankoG, 2023-07-11:
I am trying to connect esp32 with a flipsky vesc, but cannot get esp to work. I connected it only through UART because I do not have CAN bus transceiver.

thankthemaker, 2023-07-11:
For UART to work you'll have to rebuild the firmware with CANBUS_ONLY commented out in config.h

Otherwise CANBUS is used.

LankoG, 2023-07-11:
I already did that, also tried to change [platformio] default_envs = nodemcu-32s, but nothing worked. I am using vs code to upload the code with platformio, but don't think there is anything wrong there.

thankthemaker, 2023-07-11:
Ok, did you check that UART is enabled in VESC tool?
Do your VESC and ESP share a common ground?
Using a common ground is important.

LankoG, 2023-07-11:
yes when I used just the VescUart library it was able to print the data to the terminal

LankoG, 2023-07-11:
I tried reinstalling the source code and now I get this error:
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

barsikus007, 2023-12-09:
You also need to disable CANBUS_ENABLED too

btw after uploading, issue still presist

jwidess, 2024-07-24:
Oh my god thank you for this thread! I've spent the last two days trying to figure out why UART wasn't working properly. The fact that **CANBUS_ONLY** is the default **NEEDS** to be mentioned somewhere!

NOTE: The "**-D CANBUS_ENABLED -D CANBUS_ONLY**" flags are located in the Environment Variables in "**platformio.ini**" **not** in config.h. To **enable UART** on my nodemcu32, on lines 141-152 of `platformio.ini` I removed the CANBUS flags so my config looks like the following.

```ini
[env:nodemcu-32s]
platform = espressif32
board = nodemcu-32s
framework = arduino
monitor_speed = 115200
board_build.partitions = default.csv
lib_deps =
    ${common_env_data.lib_deps_external}
build_flags =
     ${ESP32.build_flags} -D LED_WS28xx
extra_scripts = pre:change_firmware_name.py
custom_firmware_name = firmware_nodemcu-32s
```

**Errors I was having:**
**rESCue App:** Always in the Disconnected State
**VESC-Tool:** "Could not read firmware version. Make sure that the selected port really belongs to the VESC"

Closed 2025-03-15.

Thread 63 (2023-08-01):

German brakelights

GulliUlli, 2023-08-01:
Hi. So i saw, that it gives brakelight Support. Is it possible to make it usable in Germany with a static breaklight (Like Cars) instead of flashing light?

GulliUlli, 2023-08-01:
Ok i Unterstand. So can i Change it by myself then? That i have 60% backlight And 100% Static brakelight? It is it fixed to flashing in the code now?

thankthemaker, 2023-08-02:
With the current firmware, the brake light brightness is fix at maximum. It's possible to change the brightness of the riding lights. In the default settings the brake lights are set to maximum (255) and the riding lights to 230.

It's also possible to completely switch off the brake lights and to change the value of the regenerative inrush current (default 4A) which triggers the brake lights.

If you want to get an overview of the settings, go and get the App for free and use the virtual rESCue device (change in settings after download) to look around and play with all options:

ios: https://apps.apple.com/de/app/rescue-app/id1572076731
android: https://play.google.com/store/apps/details?id=org.thankthemaker.rescueapp

GulliUlli, 2023-08-02:
Okey i will try it. Thx 🙏

Thread 64 (2023-08-21):

BLE Brigde Not working with new Vesc Tool App

SyedShahzebHussain, 2023-08-21:
I am trying to connect Vesc tool app V6.05, as soon as i connect ble, ESP32 gets reset and if i connect vesc tool V1.25 app everything works fine. can you help me with this issue. here is the error when i connect with new vesc tool

rst:0xc (sw_cpu_reset),boot:0x13 (spi_fast_flash_boot) configsip: 0, spiwp:0xee clk_drv:0x00,q_drv:0x00,d_drv:0x00,cs0_drv:0x00,hd_drv:0x00,wp_drv:0x00 mode:dio, clock div:1 load:0x3fff0018,len:4 load:0x3fff001c,len:1044 load:0x40078000,len:10124 load:0x40080400,len:5856 entry 0x400806a8

Starcult, 2023-08-21:
I am using vesc tool v6.02 (iphone) no problem at all .
Are you connect it from uart or can?

SyedShahzebHussain, 2023-08-22:
@Starcult I am using Android Phone and connected it from UART, as soon i connect to bluetooth using 6.05 Version App, Esp32 resets.

Closed 2023-08-23.

Thread 67 (2023-08-25):

Forward, Backward, Brake, Buzzer through CAN instead of GPIO

TronicSystems, 2023-08-25:
Hi there! Love the project :)

Is it possible to pull the Forward, Backward, Brake, and Buzzer statuses through CAN instead of GPIO? This would reduce the amount of wire connections needed if one uses the CAN bus version.

thankthemaker, 2023-08-25:
Of course, it's already implemented and the default setting to get these information over CANBUS. The GPIO support is still there for legacy reasons.

Closed 2023-11-04.

Thread 83 (2023-11-05):

UART not working on rESCue S3

thankthemaker, 2023-11-05:
UART currently isn't working on the rESCue s3.

thankthemaker, 2023-11-05:
The default GPIO for UART on the Lolin Wemos S3 mini are 43 (TX) and 44 (RX) but the firmware 2.5.0 uses 16 and 17 which are physically connected to different ports.
The GPIO mapping has to be fixed in platformio.ini for the Lolin Wemos s3 mini

Closed 2023-11-05.

Thread 88 (2023-12-06):

lightbar footpad sensor VISUAL indications not working on 2.4.1 up to 2.5.4

guerradr, 2023-12-06:
Hardware-Version: v3.1 (old board biggest one)

the lightbar footpad sensor VISUAL indications are not working on firmware versions 2.4.1 and up to 2.5.4

I reverted back to 2.3.3 and then they work.

thankthemaker, 2023-12-10:
Could you please give me some details? What isn't working?
I just tested 2.5.4 with my board and indicators seem to work.

https://github.com/thankthemaker/rESCue/assets/33477197/cae385dd-faef-42c1-b84c-a188a6ac5178

guerradr, 2023-12-10:
Yeah its wierd. The startup sequence and battery indication work fine. But the footpad sensor indicatior did not show on the lightbar. Only when I downgraded to the stated version nr. did it work again for me. Do you need further info?Am 10.12.2023 10:34 schrieb ThankTheMaker ***@***.***>:
Could you please give me some details? What isn't working?
I just tested 2.5.4 with my board and indicators seem to work.
https://github.com/thankthemaker/rESCue/assets/33477197/cae385dd-faef-42c1-b84c-a188a6ac5178

—Reply to this email directly, view it on GitHub, or unsubscribe.You are receiving this because you authored the thread.Message ID: ***@***.***>

guerradr, 2024-01-09:
Here is a short video. Apparently it's hard to replicate the behaviour when switching firmware versions. Could it be that the eeprom settings are somehow retained when flashing new firmware?
https://youtu.be/6uUoVD5nSK8?si=3yO6029yzBX9r0gn

thankthemaker, 2024-01-11:
Thanks for the video, it makes it much clearer. I'll check it again in the evening. Looks like pushing the left hand side gets recognized like an ADC-FULL while the right hand side is recognized as ADC-HALF, which is correct if only one side is pressed.

guerradr, 2024-01-11:
Yes that seems so. I’m on the newest VESC 6.02 and I have the same behavior on the UBOX SINGLE 100V and the Raiden7. I have them wired up via CAN-BUS.

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

thankthemaker, 2024-01-16:
Did you find some time to check the values in VESC tool?

I tried to reproduce the behavior but wasn't successful. I still think something is wrong with your sensor / wiring.

guerradr, 2024-01-16:
Hi, the settings are fine in the VESC Tool. You can also see in the video that the board only activates when pressing both footpad sides down. I see the same behaviour on both of my boards (UBOX Single with rESCue light and Raiden 7 with rESCue s3). There is not much I can do wrong with my wiring since I'm can bus only and i have connection via VESC Phone App. Since I had different behaviours and indications when swapping between rESCue Software Versions - are there any setting values retained in the eeprom when flashing?
Maybe you can answer me another question not related to the lightbar. When I want to do the "Setup Motors FOC" via the rESCue bluetooth bridge (CAN-Bus only), I always get an error that it is unable to write the motor settings. However I can use the VESC App fine when changing settings in the  motor and app configs. I always have to use an USB Cable for the initial motor config.

thankthemaker, 2024-01-16:
Sorry for asking again. Could yous check which state is shown in VESC tool when pressing the pads?
There's nothing configured in rESCue itself, it just checks the state it gets from VESC. So it would be very helpful to know what the stat looks like in VESC.

guerradr, 2024-01-16:
I meant the footpad indicator configuration. When I use the rESCue App I sometimes had to save the config two or three times to have the whole configuration saved on the esp32. Thus seeing different behaviours between the saved configs. I used different phones to check if my app had a problem.
Here is a screen record of my VESC App showing correct behaviour of my footpads.
https://youtu.be/eR7gBGYLcno

thankthemaker, 2024-01-17:
Thanks for the video. You're right. The behaviour in VESC tool looks as it should.
I have an idea what's going wrong, but I first have to try to reproduce the problem to fix the issue.
Thanks for your help!

0x41kravchenko, 2024-06-25:
Hi guys! I had exactly same situation and after checking the logs I saw "Unknown switch state" log. The cause was that in vescData.switchState the value was 3 for fully activated footpads. After logging switchState and comparing output from VESC tool I got following relations:
- switchState==0 - when adc1 and adc2 are both 0
- switchState==1 - when adc1 is active
- switchState==2 - when adc2 is active
- switchState==3 - when adc1 and adc2 are both active
Basically now (in relatively new VESC firmwares?) switchState fully corresponds to AdcState enum values, following code change confirmed it:
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

But I'm not sure about old versions of VESC firmwares and whether 3rd value of switchState was added recently.
I have 6.2 CheapFOCer2.

Thread 90 (2024-01-16):

Pinout for optional light connectors on rESCue s3

guerradr, 2024-01-16:
I'd like to use the rESCue s3 with the COB LED's. What PIN's of the s3 are connected to the optional light connectors 1 & 2 Dout?
Could we use them for the Mosfet control. If so I request to implement it as a standard.

guerradr, 2024-01-16:
Cool, thx for the update. I've just made my own build for the s3 mini. But I need to test it first. I figured I only had to define the Pin's in the platformio.ini?
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

thankthemaker, 2024-01-16:
Yes, if you build the firmware by yourself, that's what is needed.

Thread 91 (2024-05-16):

how to run on ESP32-C3

barsikus007, 2024-05-16:
I tried to launch that project on ESP32-C2, but board won't connect to VESC via UART

Any way to debug that?
