thankthemaker/rESCue/src/ILedController.h

#ifndef __I_LED_CONTROLLER_H__
#define __I_LED_CONTROLLER_H__

#include <Arduino.h>
#include "CanBus.h"
#include "VescData.h"

static const char* LOG_TAG_LED = "ILedController";

// Pattern types supported:
enum  Pattern { NONE, RAINBOW_CYCLE, THEATER_CHASE, COLOR_WIPE, CYLON, FADE, RESCUE_FLASH_LIGHT, PULSE, SLIDE, BATTERY_INDICATOR, TRANS_PRIDE};
// Patern directions supported:
enum  Direction { FORWARD, REVERSE };

class ILedController {
    public:    
        // pure virtual (abstract) method definitions
        virtual void init() = 0;
        virtual void stop() = 0;
        virtual void idleSequence() = 0;
        virtual void startSequence() = 0;
        virtual void changePattern(Pattern pattern, boolean isForward, boolean repeatPattern ) = 0;
        virtual void update() = 0;
        void loop(const int* new_forward, const int* new_backward, const int* idle, const int* new_brake, const int* mall_grab);

    private:
      const static int bufSize = 128;
      char buf[bufSize];
      int old_forward  = LOW;
      int old_backward = LOW;
      int old_idle     = LOW;
      int old_mall_grab= LOW;
};

class LedControllerFactory {
    public:
        static LedControllerFactory* getInstance();
        static uint8_t determineLedType();
        static uint8_t determineLedType(bool lightBar);
        static ILedController* createLedController(VescData *vescData);

    private:
        LedControllerFactory();    
        static LedControllerFactory *instance;
};

#endif //__I_LED_CONTROLLER_H__
