thankthemaker/rESCue/src/LedControllerFactory.cpp

#include "ILedController.h"
#include "Ws28xxController.h"
#include "CobController.h"

LedControllerFactory *LedControllerFactory::instance = 0;

LedControllerFactory::LedControllerFactory() = default;

LedControllerFactory *LedControllerFactory::getInstance() {
    if (instance == 0) {
        instance = new LedControllerFactory();
    }

    return instance;
}

ILedController *LedControllerFactory::createLedController(VescData *vescData) {
#ifdef LED_WS28xx
    uint8_t ledType = LedControllerFactory::determineLedType();
    //stuff for using seperate front and back pins. 
    #if defined(PIN_NEOPIXEL_FRONT) && defined(PIN_NEOPIXEL_BACK)
        return new Ws28xxController(AppConfiguration::getInstance()->config.numberPixelLight, PIN_NEOPIXEL_FRONT, PIN_NEOPIXEL_BACK, ledType, vescData);
    #else
        return new Ws28xxController(AppConfiguration::getInstance()->config.numberPixelLight, PIN_NEOPIXEL, ledType, vescData);
    #endif //LED_WS28xx
#endif
#ifdef LED_COB
    return new CobController();
#endif //LED_COB
}

uint8_t LedControllerFactory::determineLedType() {
    return determineLedType(false);
}

uint8_t LedControllerFactory::determineLedType(bool lightBar) {
    uint8_t ledType = 0;
    std::string ledTypeStr="";
    std::string ledFreqStr="";
    if (lightBar) {
        ledTypeStr = std::string(AppConfiguration::getInstance()->config.lightBarLedType.c_str());
    } else {
        ledTypeStr = std::string(AppConfiguration::getInstance()->config.ledType.c_str());
    }
    if (ledTypeStr == "RGB") {
        ledType = NEO_RGB;
    } else if (ledTypeStr == "RBG") {
        ledType = NEO_RBG;
    } else if (ledTypeStr == "GRB") {
        ledType = NEO_GRB;
    } else if (ledTypeStr == "RGBW") {
        ledType = NEO_RGBW;
    } else if (ledTypeStr == "RGWB") {
        ledType = NEO_RGWB;
    } else if (ledTypeStr == "GRBW" ) {
        ledType = NEO_GRBW;
    } else if (ledTypeStr == "GRWB") {
        ledType = NEO_GRWB;
    } else {
        ledType = NEO_RGB;
    }
    if (lightBar) {
        ledFreqStr = std::string(AppConfiguration::getInstance()->config.lightBarLedFrequency.c_str());
    } else {
        ledFreqStr = std::string(AppConfiguration::getInstance()->config.ledFrequency.c_str());
    }
    if (ledFreqStr == "800kHz" || ledFreqStr == "KHZ800") {
        ledType = ledType + 0x0000;
    } else {
        ledType = ledType + 0x0100;
    }
    return ledType;
}
