thankthemaker/rESCue/src/btbridge.cpp

#include "btbridge.h"

HardwareSerial vescSerial(2);
//BluetoothSerial bleSerial;

BLEServer *pServer = NULL;
BLECharacteristic * pTxCharacteristic;
bool deviceConnected = false;
bool oldDeviceConnected = false;

BluetoothBridge::BluetoothBridge() {}

void initBluetooth(){
  // Create the BLE Device
  BLEDevice::init(BT_NAME);

  // Create the BLE Server
  pServer = BLEDevice::createServer();
  pServer->setCallbacks(new BleServerCallbacks());

  // Create the BLE Service
  BLEService *pService = pServer->createService(SERVICE_UUID);

  // Create a BLE Characteristic
  pTxCharacteristic = pService->createCharacteristic(
										CHARACTERISTIC_UUID_TX,
										BLECharacteristic::PROPERTY_NOTIFY
									);
                      
  pTxCharacteristic->addDescriptor(new BLE2902());

  BLECharacteristic * pRxCharacteristic = pService->createCharacteristic(
											 CHARACTERISTIC_UUID_RX,
											BLECharacteristic::PROPERTY_WRITE
										);

  pRxCharacteristic->setCallbacks(new BleCallbacks());

  // Start the service
  pService->start();

  // Start advertising
  pServer->getAdvertising()->start();
  Serial.println("Waiting a client connection to notify...");
}

void BluetoothBridge::init() {
#ifdef DEBUG
  Serial.println("BluetoothBridge init");
#endif
  initBluetooth();
  //bleSerial.begin(BT_NAME);
  vescSerial.begin(VESC_BAUD_RATE, SERIAL_8N1, VESC_RX_PIN, VESC_TX_PIN, false);         
}

void BluetoothBridge::loop() {
    if (deviceConnected) {
        if(vescSerial.available()) {
          uint8_t incomingByte = vescSerial.read();
          pTxCharacteristic->setValue(&incomingByte, 1);
          pTxCharacteristic->notify();
        }
		    delay(3); // bluetooth stack will go into congestion, if too many packets are sent
	}

    // disconnecting
    if (!deviceConnected && oldDeviceConnected) {
        delay(500); // give the bluetooth stack the chance to get things ready
        pServer->startAdvertising(); // restart advertising
        Serial.println("start advertising");
        oldDeviceConnected = deviceConnected;
    }
    // connecting
    if (deviceConnected && !oldDeviceConnected) {
		// do stuff here on connecting
        oldDeviceConnected = deviceConnected;
    }
}
