thankthemaker/rESCue/src/btbridge.h

#ifndef BLUETOOTH_BRIDGE_H
#define BLUETOOTH_BRIDGE_H

#include "config.h"
#include "BluetoothSerial.h"
#include <HardwareSerial.h>
#include <BLEDevice.h>
#include <BLEServer.h>
#include <BLEUtils.h>
#include <BLE2902.h>

#define SERVICE_UUID           "6E400001-B5A3-F393-E0A9-E50E24DCCA9E" // UART service UUID
#define CHARACTERISTIC_UUID_RX "6E400002-B5A3-F393-E0A9-E50E24DCCA9E"
#define CHARACTERISTIC_UUID_TX "6E400003-B5A3-F393-E0A9-E50E24DCCA9E"

extern HardwareSerial vescSerial;
extern bool deviceConnected; 

class BluetoothBridge {
    public:
        BluetoothBridge();
        void init();
        void loop();
};

class BleServerCallbacks: public BLEServerCallbacks {
    void onConnect(BLEServer* pServer) {
      Serial.println("BLE device connected");
      deviceConnected = true;
    };

    void onDisconnect(BLEServer* pServer) {
      Serial.println("BLE device disconnected");
     deviceConnected = false;
    }
};

class BleCallbacks: public BLECharacteristicCallbacks {
    void onWrite(BLECharacteristic *pCharacteristic) {
      std::string rxValue = pCharacteristic->getValue();

      if (rxValue.length() > 0) {
        for (int i = 0; i < rxValue.length(); i++) {
          vescSerial.write(rxValue[i]);
        }
      }
    }
};

#endif
