thankthemaker/rESCue/(commit log)

2020-12-29 Fixed init of Neopixel
    [btbridge.cpp, ledcontroller.cpp, ledcontroller.h, main.cpp]
2020-12-31 initial BLE bridge working with VESC app
2021-01-02 cob wiring
2021-01-02 neopixel wiring
2021-01-03 first working battery and ble version
2021-01-04 battery monitor ready
2021-01-04 sounds for battery monitor
2021-01-17 Initial support for CANBUS
2021-01-28 Working BatteryMon with CAN
2021-03-06 adjustments for PCB, increased debugging
2021-03-10 Updated battery monitor image
2021-03-26 Battery monitor, LED improvements, buzzer pin GPIO25
    [BatteryMonitor.cpp, BatteryMonitor.h, CobController.cpp, CobController.h, ILedController.cpp, ILedController.h, Ws28xxController.cpp, Ws28xxController.h]
2021-03-28 Refactoreing, NimBLE library, Logging-Framework
2021-04-02 Sending VESC data to Blynk
2021-04-02 Support for ESP32 D1 Minit and ESP32 Dev Module
2021-04-02 fixed typo in import
    [Ws28xxController.cpp]
2021-04-09 Fixed ifdef CANBUS_ENABLED
2021-04-11 Changed buzzer to RTTTL library
    [BatteryMonitor.cpp, Buzzer.cpp, Buzzer.h, RTTTL.cpp, RTTTL.h, config.h, main.cpp]
2021-04-14 Blynk and CANBUS improvements
2021-04-19 added OTA-update
    [min_spiffs.csv]
2021-04-26 Updated LEDs to background update
2021-04-27 Fixed small fading bug, changed default start sound
    [AppConfiguration.cpp, Ws28xxController.cpp]
2021-04-29 Updated config and doc according to PCB rev3
2021-05-08 fixed diagram, wiring of neopixel
2021-05-15 fixed wrong macro definition
    [BleServer.cpp]
2021-06-05 Preparation for CANBUS-only
2021-06-11 fixed auth token handling
    [BleServer.cpp, config.h]
2021-06-24 Small improvements, bugfixes, new light pattern (pulse)
    [ILedController.h, Ws28xxController.cpp, Ws28xxController.h]
2021-06-26 Footpad sensor state in lightbar
2021-06-28 Bugfixes, erpm was read wrong
    [BatteryMonitor.cpp, CanBus.cpp, ILedController.cpp, Ws28xxController.cpp, config.h, main.cpp]
2021-07-19 Bugfixes for CAN communication, synchronize sent messages and seperate / increase buffer
    [BleServer.cpp, CanBus.cpp, CanBus.h, LightBarController.cpp]
2021-07-20 Fixed some bugs (see Readme.md)
    [default.csv]
2021-08-16 Fixed compile errors when COB is enabled
    [CobController.cpp, CobController.h]
2021-08-16 fixed CAN-issue with VESC version 5.3
    [CanBus.cpp, config.h]
2021-08-16 eleminated hard coded VESC-ID
2021-08-22 Fixed error in CANBUS-Lib. Without working CANBUS sending messages makes EDP freeze. Semaphore not given
    [CanBus.cpp, CanBus.h]
2021-08-22 Moved CANBUS-Lib to lib folder, Read loglevel from config
2021-08-22 Fixed some COB issues
    [CobController.cpp, CobController.h, Ws28xxController.h, config.h]
2021-08-22 Added mosfet switch image
2021-09-05 Added buy button
2021-09-09 Updated PCB
2021-09-12 - reverted change in CANBUS lib - fixed some minor issues in CANBUS
    [CanBus.cpp]
2021-12-01 preparation change CANBUS lib
2021-12-06 Version 2.0.1 fixed default value of otaUpdateActive property. ESP32s with erased flash got stuck
    [AppConfiguration.cpp]
2021-12-06 Fix: save the config outside of BLE onWrite
    [AppConfiguration.h, BleServer.cpp, main.cpp]
2021-12-08 Some small fixes regarding default values
    [AppConfiguration.cpp, AppConfiguration.h, BatteryMonitor.cpp, CanBus.h]
2021-12-18 configurable battery values
2021-12-20 configurable battery values & LED type
2021-12-22 - fixed lightbar - fixed batmon - prepared version2.0.4
    [BatteryMonitor.cpp, BatteryMonitor.h, ILedController.h, LedControllerFactory.cpp, LightBarController.cpp, LightBarController.h, config.h]
2022-04-16 - added wifi update again - can-communication bugfixing
    [BleCanProxy.cpp, BleCanProxy.h, BleServer.cpp, BleServer.h, CanBus.cpp, CanBus.h, CanDevice.cpp, CanDevice.h]
2022-04-16 #27: Fixed switchstate printed wrong
    [CanBus.cpp]
2022-05-11 Added new idle light pattern "Battery-Indicator"
2022-05-22 Fixed compile errors in XT_DAC_AUDIO lib with newer espressif ESP32 frameword
2022-10-09 #44: Fixed idle light flickering
    [Ws28xxController.cpp]
2022-10-09 #42: Bugfix lightbar not adjusting to number of pixels
    [LightBarController.cpp]
2022-10-15 #47: Make UART (version without CANBUS) work again
2022-10-15 #47: Set CANBUS as default again
2022-11-14 Updated to Espressif TWAI lib to support newer ESP32 revisions
2022-12-08 Updated dependencies, fixed delay when sending CAN frames
    [BleServer.cpp, CanDevice.cpp]
2023-04-15 Support for additinal LED Types, now uses separate W-LED
2023-04-17 Refactoring, remove fake canbus
2023-07-30 Initial version of new update mechanism and some bigfixes
    [huga_app.csv]
2023-08-24 Support added for avaspark-rgb board target. Fixed being able to define CAN bus pins as opposed to hardcoded. Overloaded Ws28xxController setPixelColor functions to support seperate front/back GPIO p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
    [CanDevice.cpp, CanDevice.h, LedControllerFactory.cpp, Ws28xxController.cpp, Ws28xxController.h, main.cpp]
2023-09-09 Fixed Macros for ESP32-S3
    [CanDevice.h]
2023-09-23 fixed uart init if canbus only
    [main.cpp]
2023-10-13 VESC Proxy fix for long packets.
    [BleCanProxy.cpp]
2023-10-13 whoops forgot trans pride pattern type. Fix for led frequency support for seperate led bar type and frequency support for reversing led bar
    [avaspark-rgb.csv]
2023-10-13 Support for OneWheel stock BMS. Reads BMS data with OWIE library. Forwards to VESC as VESC BMS CAN.
2023-10-13 Updated BMS config Instructions for BMS_ON to specify any GPIO pin as opposed to just UART. Move BMS Battery config from broadcastVESCBMS to private member variables.
2023-10-14 Support for upcoming BMS tiltback.
2023-10-14 Full support for BMS FAULT codes.
2023-10-14 "mall grabbing" support lol XD Displays battery when pitch >70 This is useful on the XR with no lightbar Fixed two other config vars
    [AppConfiguration.cpp, AppConfiguration.h, ILedController.cpp, ILedController.h, main.cpp]
2023-10-15 Fix: Give semaphore also on error
    [BleServer.cpp, CanDevice.cpp]
2023-10-15 Fixed enum. Fixed config typo. added some vars for future BMS IMBALANCE fault codes.
    [AppConfiguration.cpp, BMSController.cpp, BMSController.h, ILedController.h, main.cpp]
2023-10-19 Fix null pointer derference when loading config. Fix actually loading new vars from rESCue Tool change LedFreqStr name (also in rESCue Tool)
    [AppConfiguration.cpp, BleServer.cpp, LedControllerFactory.cpp, main.cpp]
2023-10-29 Support for old ledfreq KHZ800
2023-10-29 Switched logging to ESP-Logging
2023-11-04 add example alternate board run command
2023-11-04 add Huzzah ESP32 pinout diagram
2023-11-04 add board Adafruit Feather ESP32
    add environment for adafruit_feather_esp32_v2
    add environment for adafruit feather_esp32
    update pins for feather_esp32
2023-11-05 Fixed GPIO mapping for UART (2) on Lolin Wemos s3 mini
    [main.cpp]
2023-11-05 Fix Lightbar init and writing of config params
    [AppConfiguration.cpp, AppConfiguration.h, BleServer.cpp, LightBarController.cpp, LightBarController.h, config.h, main.cpp]
2023-11-27 Add a delay to avoid brownouts
    [main.cpp]
2024-08-29 untested cherry pick of poc for floaty support / readout of vesc serial data <=8 from the float app via can serial forward
2024-09-01 bugfix, revert to working code where vesc_id gets properly set (sorry for that)
    [CanBus.cpp]
2024-09-01 reboot now after applying new config to apply new vesc id immediate
    [main.cpp]
2025-03-12 Support for esp32doit_devkit_v1(_uart) fixes #61
2026-10-30 Refactor VESC communication behind a transport interface
    Extract the transport independent parts of the VESC communication so that
    CANBUS and UART share one implementation and BleServer/main no longer depend
    on a concrete CanBus:
    - add IVescCommunication interface with a shared VescCommunicationBase that
    keeps the polling/retry scheduling and the connected state in one place
    - add VescCommunicationFactory to pick the transport from the build config
    - move VESC command decoding into a transport independent VescCommandParser
    with bounds checked reads
    - add a Uart implementation (previously the UART mode had no status parsing)
    - decouple BleServer from CanBus (depends on IVescCommunication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
2026-10-30 Add native unit tests for the VESC command parser
    - make VescCommandParser a pure function of (bytes, length, batteryDrift, now)
    so it no longer depends on the Arduino framework and can run on the host
    - add test/test_vesc_command_parser covering decoding, battery drift and
    bounds safety of truncated/empty/null input
    - wire up [env:native] (unity, host-incompatible libs ignored) and run the
    tests in CI via 'pio test -e native'
    - drop the byte-identical duplicate lib/vesc-protocol/src/buffer.c, which
    made the native build fail with 'Multiple ways to build the same target'
2026-10-30 Fix CANBUS receive ids (regression from the transport refactor)
    The refactor unified the send and receive identifier computation, which set
    bit 31 on the RECV_* constants. The TWAI driver masks received extended ids to
    29 bits, so those constants could never match an incoming frame and the CANBUS
    transport silently stopped decoding any data.
    - restore the original split: canReceiveId() builds the 29 bit wire format,
    canSendId() keeps the previous transmit form
    - move the id helpers into a host-testable header (src/VescCanId.h)
    - add test/test_vesc_can_id guarding the 29 bit invariant
2026-10-30 Fix CAN<->BLE proxy transparency for short-buffer replies
    Writing the motor or app configuration through the proxy failed: the VESC
    answers COMM_SET_MCCONF / COMM_SET_APPCONF with a one byte payload, which is
    transferred in a CAN short buffer frame. Analysed against the VESC firmware
    (comm/comm_can.c, comm/commands.c, util/crc.c):
    - short buffer frames are laid out as [controller id, send flag, payload...]
    and carry NO CRC. The proxy took the payload from index 1 (one byte too
    early), ignored the CRC that has to be derived from the payload and, because
    it required a data length of at least 6, dropped the 3 byte ack frame
    entirely - so the app never got its reply and reported an erro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
2026-10-30 Speed up the CAN proxy: pace on the TX queue instead of a delay per frame
    CanDevice::sendCanFrame() slept a fixed millisecond after every frame, so a
    transfer cost ~1 ms per CAN frame - linear in the payload size (500 B = 79
    frames = ~79 ms, 4 KB = 678 frames = ~0.7 s). The frame count is driven by the
    proxy packetizer (7 bytes/frame up to offset 255, 6 bytes/frame beyond).
    - drop the blind delay, let twai_transmit() block until the queue has room
    (CAN_TX_TIMEOUT_MS) so the bus becomes the limit and no frame is dropped
    - raise tx_queue_len from 10 to 64 so a whole burst is absorbed
    - log payload size, frame count and duration per proxy transfer (>50 ms at
    info level) so the throughput c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
2026-10-30 Make the CAN proxy tolerate arbitrary client chunks
    The proxy state machine assumed one VESC packet per BLE write: a write carrying
    more than one packet lost the remainder, leading garbage was never resynced and
    an aborted transfer left 'processing' set forever - which keeps requestSlotBusy()
    true and silently pauses all periodic VESC polling until reboot.
    - add vesc_packet_next(): finds the next complete packet in a raw stream, skips
    leading garbage and resynchronises when the end byte is missing (unit tested
    for single/split/consecutive packets, garbage and >255 byte payloads)
    - BleCanProxy::proxyIn() now accumulates, forwards every complete packet and
    erases consumed bytes
    - drop a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
2026-10-30 Reclaim ~78 kB of RAM from oversized CAN proxy buffers
    The VESC never transfers a payload larger than PACKET_MAX_PL_LEN (512 bytes,
    see comm/packet.h), which makes all of these comfortably oversized:
    - loopback stream 65535 -> 4096 bytes (~60 kB) - it is drained every main loop
    - CAN RX queue 1000 -> 128 entries (~18 kB) - it is drained every main loop
    - proxy RX buffer 8192 -> 2048 bytes
    - assembled payload cap 4096 -> 2048 bytes
    No functional change: nothing legitimate comes close to these limits.
2026-10-30 Run the CAN proxy from the main loop instead of the BLE callback
    A whole proxy transfer (parsing, framing, CAN burst) used to run inside
    onWrite, i.e. in the NimBLE host task: the client's next write could not be
    serviced while the burst was on the wire. The proxy state was also touched from
    both tasks (rx buffer, partial-packet state) without any synchronisation.
    - proxyIn() now only hands the incoming bytes over behind a mutex
    - new BleCanProxy::loop() does all parsing, framing and CAN I/O and is called
    from CanBus::afterRead() on the main loop
    - bounded by design: a VESC payload is at most 512 bytes (~79 CAN frames), so a
    transfer needs no per-iteration budget
    - 'processing' is now o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
2026-10-30 Tidy up BleServer state
    Behaviour neutral, except that stop() no longer leaves stale state behind:
    - move the ATT MTU / notification packet size from file scope globals into the
    class (they are only touched by BleServer)
    - remove the unused globals value, updateBuffer and frameNumber
    - reset deviceConnected / oldDeviceConnected / vescBuffer in stop()
2026-11-01 Pin the espressif32 platform so builds are reproducible
    CI installs the toolchain from scratch and 'platform = espressif32' is
    unpinned, so it now resolves to Arduino core 3.3.12 - where ledcSetup() and
    ledcAttachPin() (used by CobController) no longer exist. Any fresh checkout,
    including master, fails the build for that reason; only a machine with an older
    platform in its cache still builds.
    Pin to the version this firmware is developed against (espressif32 6.10.0,
    Arduino core 2.0.17). Migrating to core 3.x is a separate change.
2026-11-01 Only version firmware artifacts for a tag
    The rename and checksum steps interpolate github.ref_name into the file name.
    For a branch name containing '/' (e.g. refactor/vesc-communication) that builds
    a path like 'firmware_x-vrefactor/vesc-communication.bin' and mv fails - which is
    what turned CI red on this branch. Both steps only make sense together with the
    release step below them, which is already tag gated.
